bzisjo/Skate/IMU_Data/XDropPlotAll.jpg

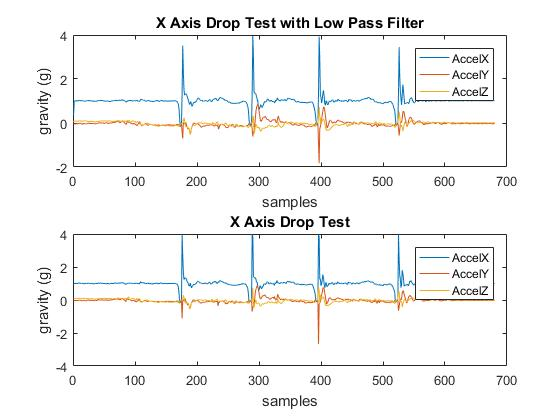
IMU_Data/XDropPlotAll.jpg
