bzisjo/Skate/IMU_Data/XDropPlotXOnly.jpg

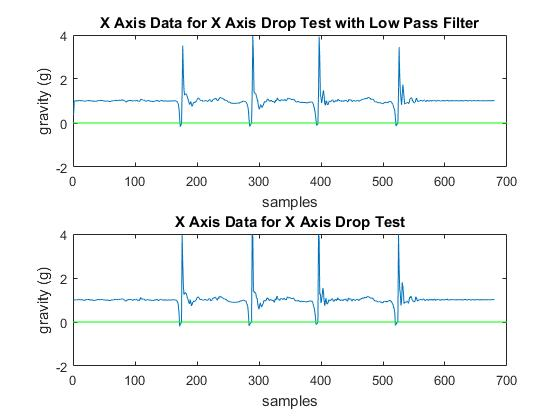
IMU_Data/XDropPlotXOnly.jpg
