bzisjo/Skate/IMU_Data/YDropPlotAll.jpg

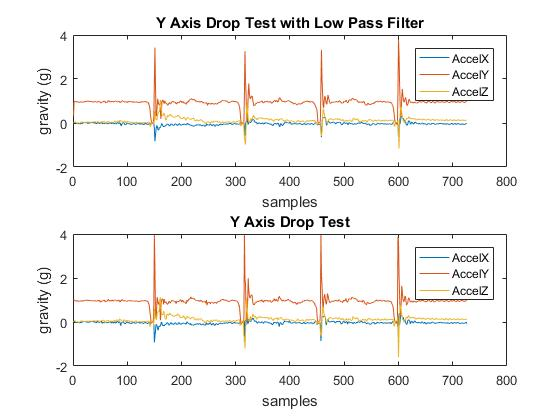
IMU_Data/YDropPlotAll.jpg
