bzisjo/Skate/IMU_Data/YDropPlotYOnly.jpg

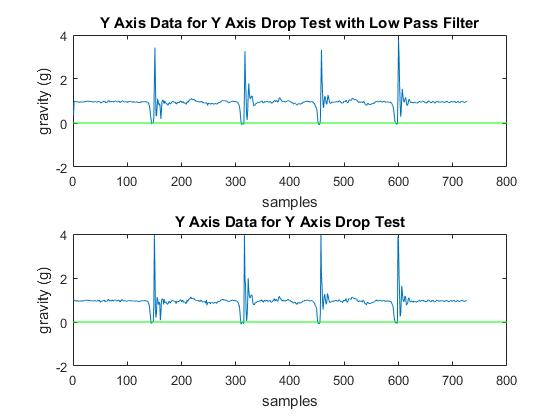
IMU_Data/YDropPlotYOnly.jpg
