bzisjo/Skate/IMU_Data/ZDropPlotAll.jpg

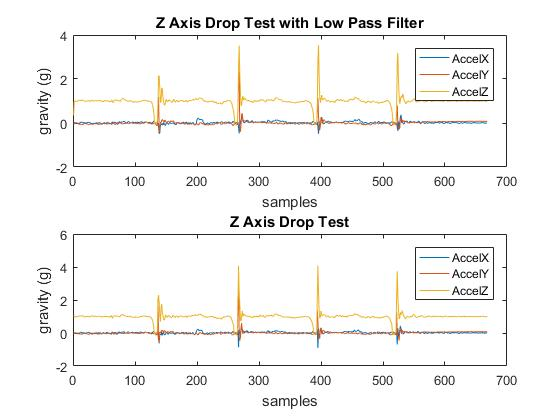
IMU_Data/ZDropPlotAll.jpg
