bzisjo/Skate/IMU_Data/ZDropPlotZOnly.jpg

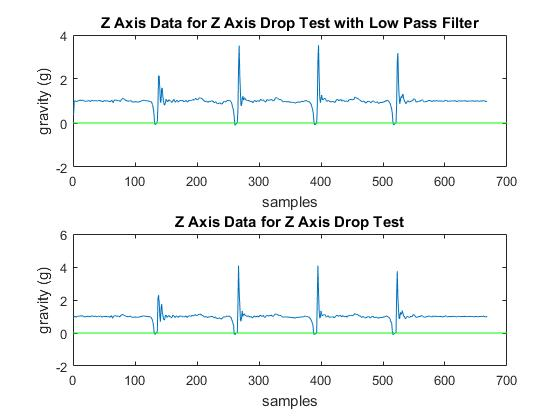
IMU_Data/ZDropPlotZOnly.jpg
