bzisjo/Skate/sch.png

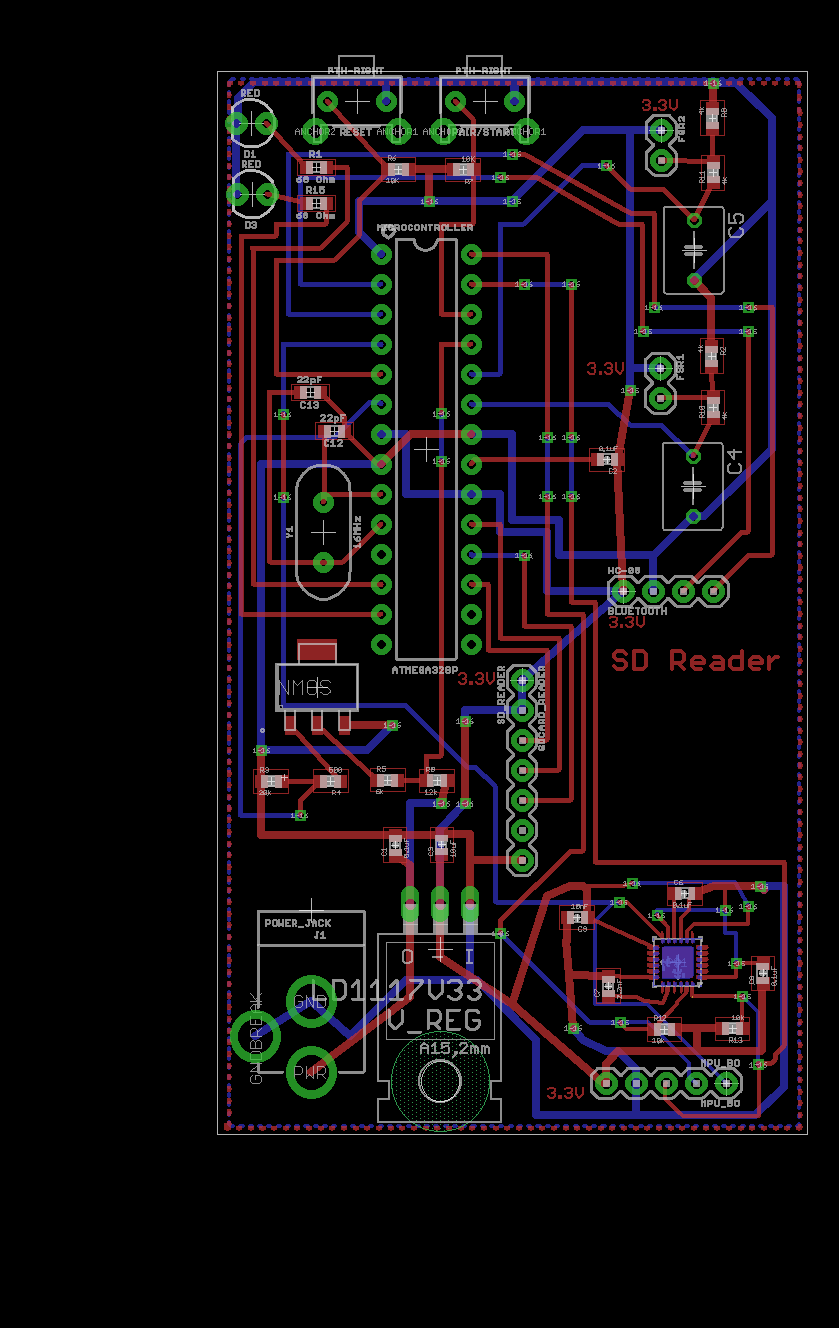
sch.png
