bzisjo/Skate/sd-reader_circuit_20090330/sd-reader.png

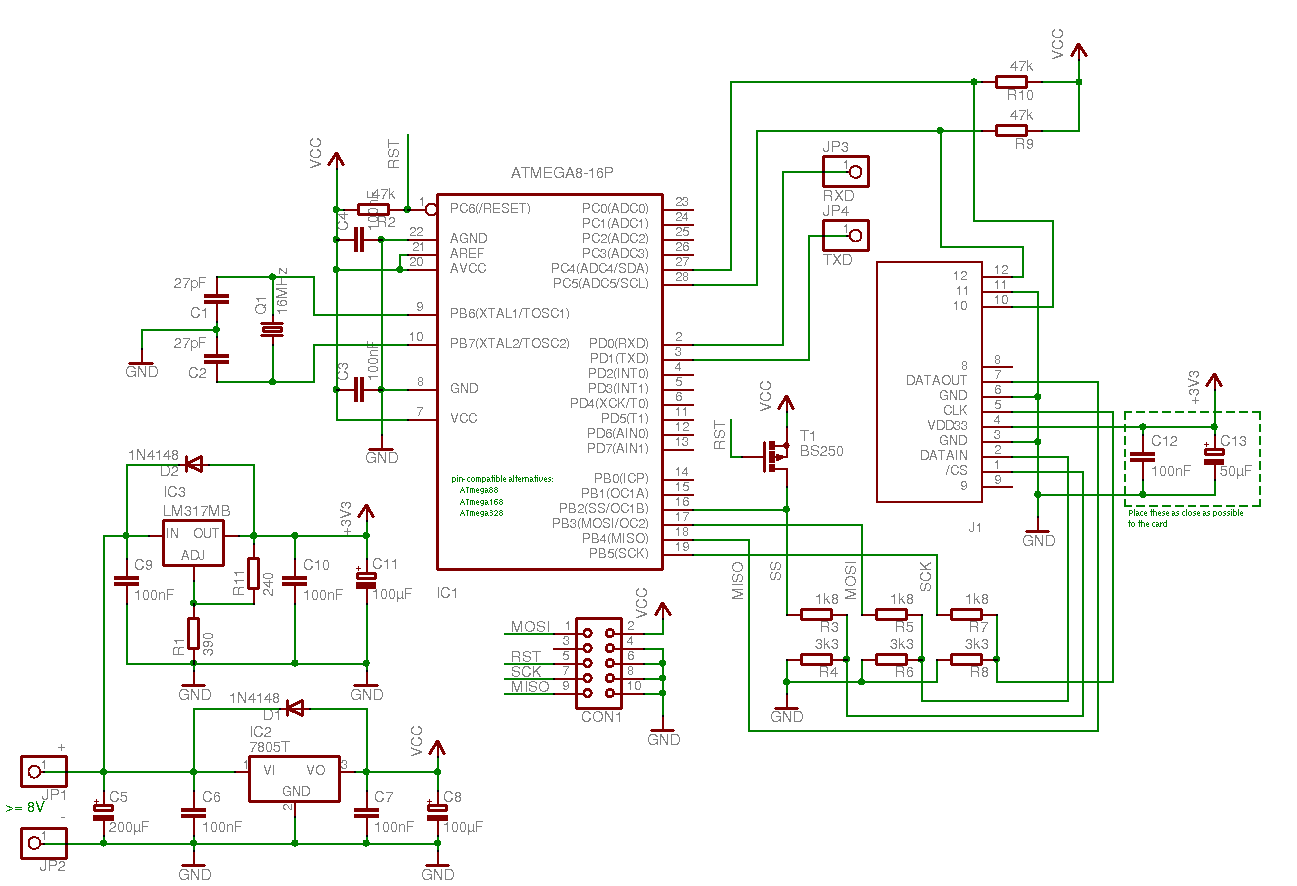
sd-reader_circuit_20090330/sd-reader.png
