bzisjo/Skate/sd-reader_circuit_20090330/sd-reader.pdf

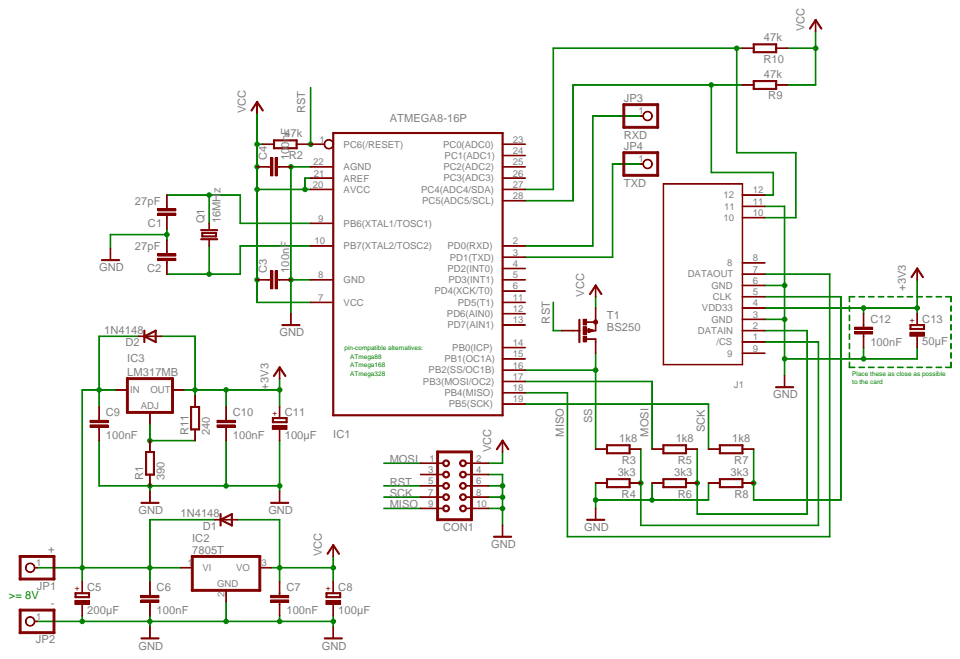
[picture p50: page 1]

Place these as close as possible
to the card
