bzisjo/Skate/Schematics/Overall/Master Device.brd

## EAGLE design Schematics/Overall/Master Device.brd (2017-03-29)

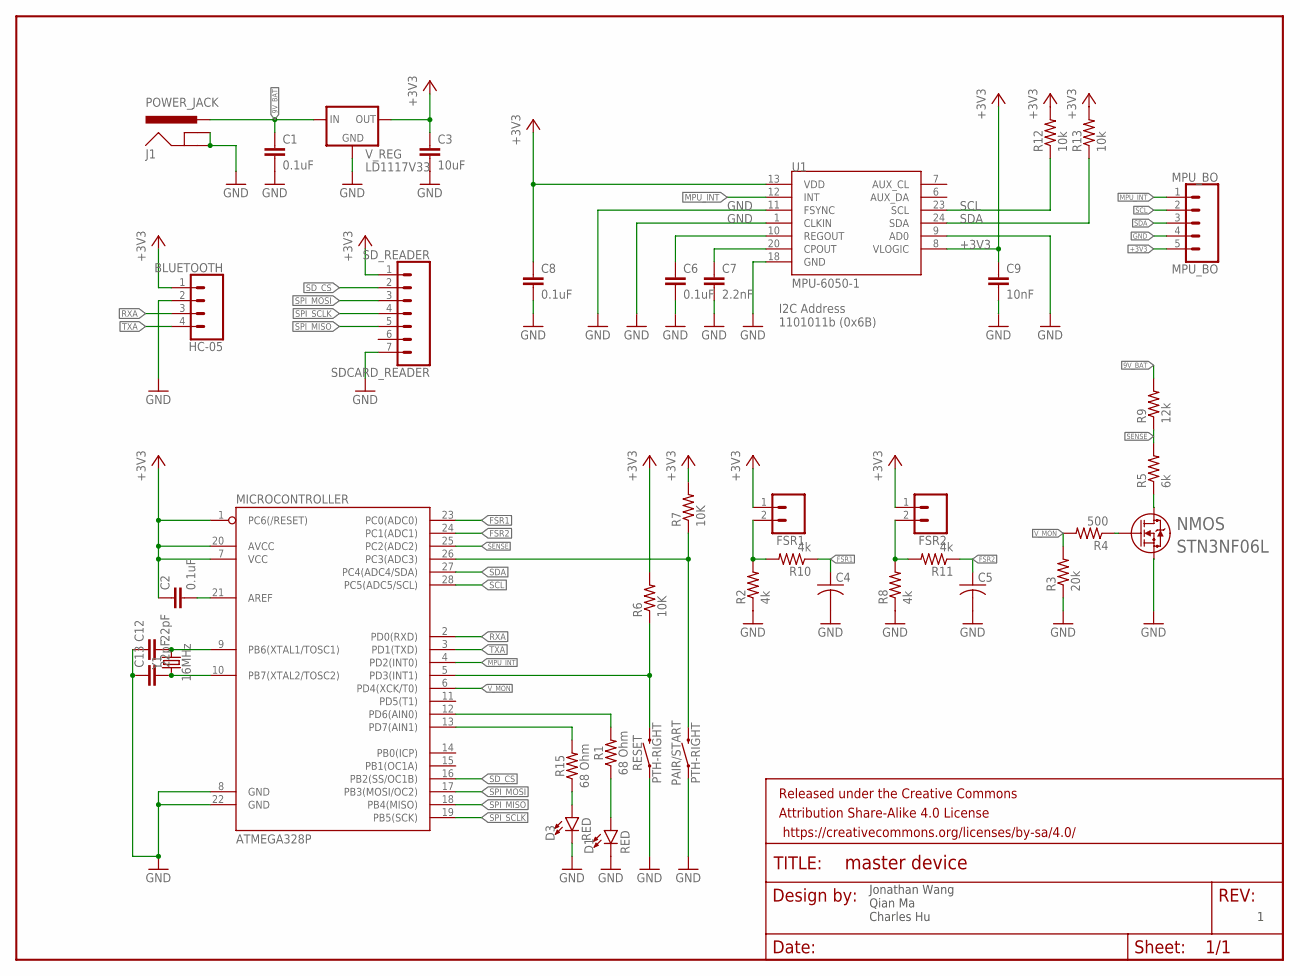
[picture p51: schematic Master Device.sch]

Parts:
C1, C2, C6, C8: 0.1uF; 0603-CAP
C3: 10uF; 0603-CAP
C4, C5: C-US050-050X075; C050-050X075
C7: 2.2nF; 0603-CAP
C9: 10nF; 0603-CAP
C12, C13: 22pF; 0603
D1, D3: RED; LED_3MM
FRAME1: FRAME-LETTERNO_PACKAGE; DUMMY
FSR1, FSR2: CONN_02; 1X02
HC-05: BLUETOOTH; 1X04
J1: POWER_JACK; POWER_JACK_PTH
MICROCONTROLLER: ATMEGA328P; DIP28
MPU_BO: MPU_BO; 1X05
NMOS: STN3NF06L; SOT-223
PAIR/START: PTH-RIGHT; TACTILE_SWITCH_PTH_RIGHT_ANGLE_KIT
R1, R15: 68 Ohm; 0603
R2, R8, R10, R11: 4k; 0603-RES
R3: 20k; 0603-RES
R4: 500; 0603-RES
R5: 6k; 0603-RES
R6, R7: 10K; 0603-RES
R9: 12k; 0603-RES
R12, R13: 10k; 0603-RES
RESET: PTH-RIGHT; TACTILE_SWITCH_PTH_RIGHT_ANGLE_KIT
SDCARD_READER: SD_READER; 1X07
U1: MPU-6050-1; QFN-24-4MM2
V_REG: LD1117V33; 78XXL
Y1: 16MHz; HC49US

Connections:
9V_BAT: C1.1, J1.PWR, R9.2, V_REG.OUT (IN)
+3V3: C2.1, C3.1, C8.1, C9.1, FSR1.1, FSR2.1, HC-05.1, MICROCONTROLLER.1 (PC6(/RESET)), MICROCONTROLLER.7 (VCC), MICROCONTROLLER.20 (AVCC), MPU_BO.5, R6.2, R7.2, R12.2, R13.2, SDCARD_READER.1, U1.8 (VLOGIC), U1.13 (VDD), V_REG.GND (OUT)
FSR1: C4.1, MICROCONTROLLER.23 (PC0(ADC0)), R10.1
FSR2: C5.1, MICROCONTROLLER.24 (PC1(ADC1)), R11.1
GND: C1.2, C3.2, C4.2, C5.2, C6.2, C7.2, C8.2, C9.2, C12.1, C13.1, D1.K (C), D3.K (C), HC-05.2, J1.GND, J1.GNDBREAK, MICROCONTROLLER.8 (GND), MICROCONTROLLER.22 (GND), MPU_BO.4, NMOS.3, PAIR/START.1, R2.1, R3.1, R8.1, RESET.1, SDCARD_READER.7, U1.1 (CLKIN), U1.9 (AD0), U1.11 (FSYNC), U1.18 (GND), V_REG.IN (GND)
MPU_INT: MICROCONTROLLER.4 (PD2(INT0)), MPU_BO.1, U1.12 (INT)
unnamed: C2.2, MICROCONTROLLER.21 (AREF)
unnamed: MICROCONTROLLER.5 (PD3(INT1)), R6.1, RESET.2
unnamed: MICROCONTROLLER.26 (PC3(ADC3)), PAIR/START.2, R7.1
unnamed: MICROCONTROLLER.12 (PD6(AIN0)), R1.2
unnamed: MICROCONTROLLER.13 (PD7(AIN1)), R15.2
unnamed: D3.A, R15.1
unnamed: D1.A, R1.1
unnamed: FSR1.2, R2.2, R10.2
unnamed: C7.1, U1.20 (CPOUT)
unnamed: C6.1, U1.10 (REGOUT)
unnamed: NMOS.1, R4.1
unnamed: NMOS.2, R5.1
unnamed: C13.2, MICROCONTROLLER.10 (PB7(XTAL2/TOSC2)), Y1.1
unnamed: FSR2.2, R8.2, R11.2
unnamed: C12.2, MICROCONTROLLER.9 (PB6(XTAL1/TOSC1)), Y1.2
RXA: HC-05.3, MICROCONTROLLER.2 (PD0(RXD))
SCL: MICROCONTROLLER.28 (PC5(ADC5/SCL)), MPU_BO.2, R12.1, U1.23 (SCL)
SDA: MICROCONTROLLER.27 (PC4(ADC4/SDA)), MPU_BO.3, R13.1, U1.24 (SDA)
SD_CS: MICROCONTROLLER.16 (PB2(SS/OC1B)), SDCARD_READER.2
SENSE: MICROCONTROLLER.25 (PC2(ADC2)), R5.2, R9.1
SPI_MISO: MICROCONTROLLER.18 (PB4(MISO)), SDCARD_READER.5
SPI_MOSI: MICROCONTROLLER.17 (PB3(MOSI/OC2)), SDCARD_READER.3
SPI_SCLK: MICROCONTROLLER.19 (PB5(SCK)), SDCARD_READER.4
TXA: HC-05.4, MICROCONTROLLER.3 (PD1(TXD))
V_MON: MICROCONTROLLER.6 (PD4(XCK/T0)), R3.2, R4.2

Notes on the sheet:
I2C Address 1101011b (0x6B)
Jonathan Wang Qian Ma Charles Hu

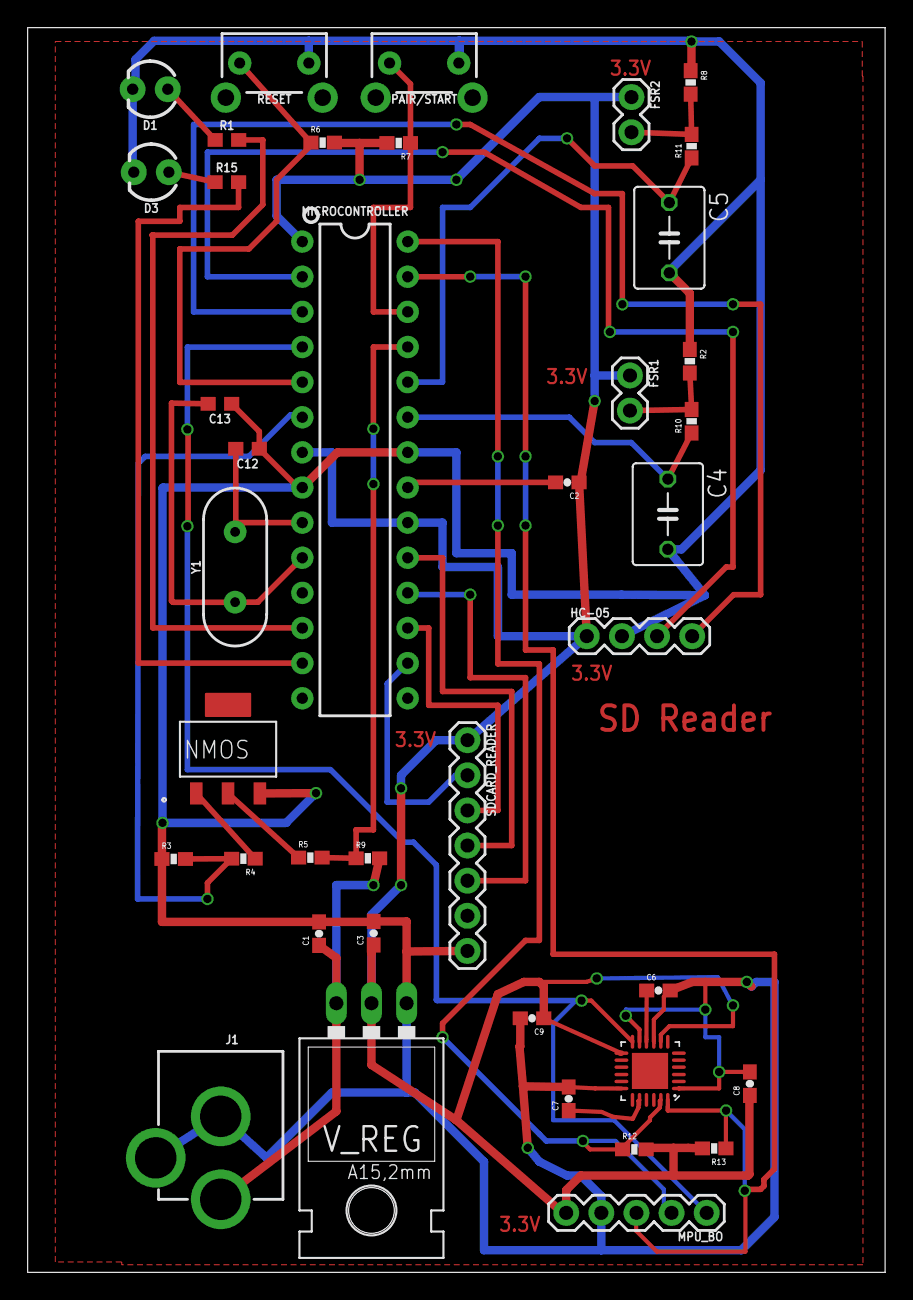
[picture p52: board Master Device.brd from above]

Board: 2 copper layers, 62.0 x 90.0 mm, 41 parts (0 on the bottom side), 31 nets.
