bzisjo/Skate/(commit log)

2017-03-10 Updated Master with battery sensor
    [Master Device.sch, Slave Device.sch]
2017-03-13 Added working UART Library for AVR
    Also MPU6050 AVR Library, yet to be successfully implemented
    [atmega8_mpu6050_sample.sch]
2017-03-14 Finalized Schematics
    [Master Device.sch]
2017-03-15 worked on pcb layout
    [Master Device.brd, Master Device.sch]
2017-03-16 eagle cad is cancer
    [Master Device.brd]
2017-03-16 Finished this fucking piece of shit
    [Master Device.brd]
2017-03-16 Added shape node to bottom for GND
    [Master Device.brd, Master Device.sch]
2017-03-16 Im done with this shit
    [Master Device.brd]
2017-03-22 Read commet details
    External clock is used (LFuse 0xFF)
    System still at 3.3V (although 5V is suggested, things seem to function as of now)
    Getting raw data from the IMU works. Remember to set the SCL_CLOCK
2017-03-27 I'm not sure what changed. But here are changes.
    [Master Device.brd, Master Device.sch]
2017-03-28 Figured out uSD stuff
    Sort of.
    [sd-reader.sch]
2017-03-29 Gerber final round
    [Master Device.brd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]
2017-03-31 test data for imu
2017-04-04 Implemented a complimentary filter
2017-04-05 arduino code change
2017-04-07 microcontroller does not freeze anymore. added data of complimentary filter with different tau values
2017-04-09 Added more tests for tau values of the compilmentary filter
2017-04-09 test some of code and did some data collection for configuring the IMU
2017-04-10 added matlab script for analysing IMU capture data
2017-04-10 Merge branch 'master' into chu
    changed 2 numbers in IMU rv table to make easier to get points
2017-04-10 Merge branch 'master' into chu
    did tests with 50ms reads because 10 ms reads were not getting captured correctly
    [main.c]
2017-04-10 This file contains all the RV tables
    Feel free to print it out and cross off items from the list
2017-04-10 MESSY UART
2017-04-18 added trace dump
2017-04-19 undid library's own inaccurate calibratations and ran some tests
2017-04-19 Prototype done
2017-04-19 verification of low pass filter
2017-04-19 fsr and timer
2017-04-20 Added some LED stuff. Doesn't compile.
    [main.c]
2017-04-20 calibrated other imu and did mahony rotation tests
2017-04-24 raw yaw test
2017-04-24 continued scripting and making sense of IMU
2017-04-25 comp filter, lpf, drop tests
2017-04-25 rv IMU
2017-04-25 edited imu verification
2017-04-26 tests on arduino
2017-04-26 added second still arduino test
2017-04-26 Silly mistakes have been fixed
    [main.c]
2017-04-26 Reenabled all of the nmos circuits
2017-04-26 Added counter and fixed shit
    [main.c, mpu6050filtering.c, mpu6050filtering.h]
